ultrazohm/uz_per_torque_box/Project Outputs for uz_per_torque_box/Rev01/confirmed_production_files/6934703554560-Produce_DanZhi.SMT_Snapshot.Top.3469584A_Y79.SMT02406261808483.png

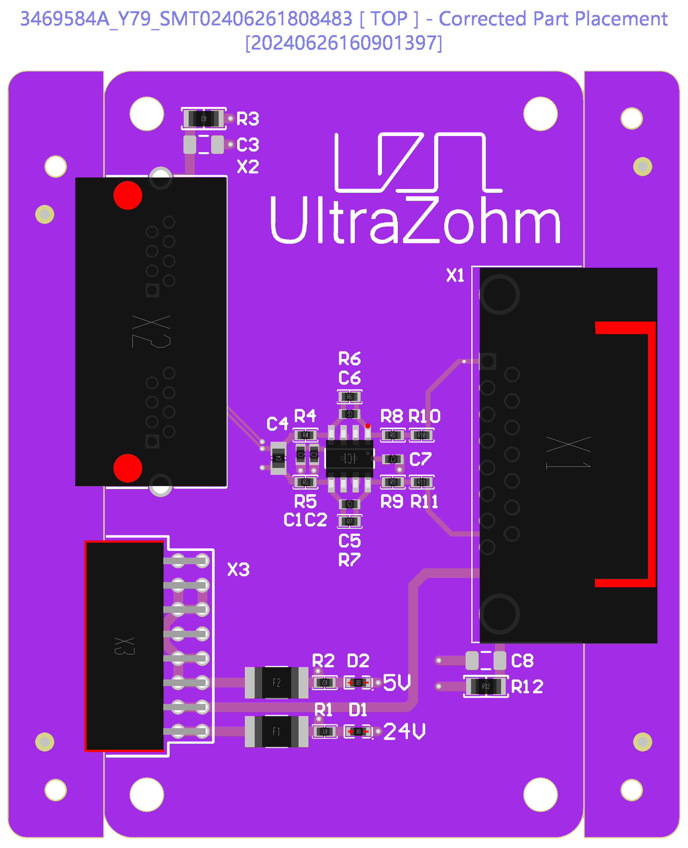
Project Outputs for uz_per_torque_box/Rev01/confirmed_production_files/6934703554560-Produce_DanZhi.SMT_Snapshot.Top.3469584A_Y79.SMT02406261808483.png
