ultrazohm/uz_per_torque_box/Project Outputs for uz_per_torque_box/Rev01/BOM/BOM_JLC-uz_per_torque_box(Default).xlsx

Quantity | Comment | Designator | Manufacturer | Value | Description | Footprint | Voltage | Dielectric | Manufacturer Part Number | LCSC Part Number
1 | 0.1 µF | C1 | KEMET | 0.1 µF | Capacitor 0603, 50 VDC, 0.1 µF, X7R | C_0603 |  |  | C0603X104K5RAC7411 | C14663
1 | 1 nF | C2 | YAGEO | 1 nF | Capacitor 0603, 50 VDC, 1 nF, NP0 | C_0603 |  |  | CC0603JRNPO9BN102 | C106246
1 | 2.2 µF | C4 | KEMET | 2.2 µF | Capacitor 0805, 16 VDC, 2.2 µF, X7R | C_0805 |  |  | C0805X225J4RECAUTO
2 | 22 pF | C5, C6 | KEMET | 22 pF | Capacitor 0603, 50 VDC, 22 pF, X7R | C_0603 |  |  | C0603C220J5RACTU
1 | 1 µF | C7 | Taiyo Yuden | 1 µF | 50V 1uF X7R ±10% 0603 Multilayer Ceramic Capacitors MLCC - SMD/SMT ROHS | C_0603 |  |  | UMK107AB7105KA-T | C105174
2 | 150060BS84000 | D1, D2 | Wuerth Elektronik |  | WL-SMCW SMD Mono-color Chip LED Waterclear Blue | WL-SMCW_0603 |  |  | 150060BS84000 | [NoParam], C5197644
2 | Littelfuse_PTC_1812 | F1, F2 | Littelfuse | PTC, 1.1 A, 24V | POLYSWITCH RESETTABLE DEVICES | 1812_PTC_Polyfuse_Littelfuse | 24V |  | Littelfuse_PTC_1812 | C70119
1 | ADA4940-1ARZ-R7 | IC1 | Analog Devices | differential ADC driver | Differential ADC Driver | SOIC-8-N |  |  | ADA4940-1ARZ-R7
4 | Mounting Hole | MH1, MH2, MH3, MH4 | Mounting Hole | Mounting Hole | Mounting Hole | MH_3.4 |  |  | Mounting Hole
1 | 24k9 | R1 | Vishay | 24k9 | SMD resistor 1% | RES 0603_1608 |  |  | CRCW060324K9FKEA
1 | 3k | R2 | KOA Speer | 3k | SMD resistor E24 series | RES 0603_1608 |  |  | RK73B1JTTD302J
2 | 0R | R3, R12 | UNI-ROYAL | 0R | 250mW Thick Film Resistors ±800ppm/℃ ±1% 0Ω 1206 Chip Resistor - Surface Mount ROHS | RES 1206_3216 |  |  | 1206W4F0000T5E | C17888
2 | 51R1 | R4, R5 | YAGEO | 51R1 | SMD resistor 0.1% | RES 0603_1608 |  |  | RT0603BRD0751R1L | C2684558
6 | 1k | R6, R7, R8, R9, R10, R11 | IRC / TT Electronics | 1k | SMD resistor 0.1% | RES 0603_1608 |  |  | PCF-W0603LF-03-1001-B-P-LT | C110776
1 | DS1037-15FNAKT74-0CC | X1 | CONNFLY Elec |  | 15 Female D-Sub Shrouded 2 3A -40℃~+85℃ Plugin D-Sub/DVI/HDMI Connectors ROHS | PCB - MISC - DSUB15 |  |  | DS1037-15FNAKT74-0CC | C77835
1 | RJHSE538002 | X2 | Amphenol |  | CAT5, RJ45 Connector, 1x2 | RJHSE-5380-02 |  |  | RJHSE538002
1 | IPL1-108-01-L-D-RA-K | X3 | SAMTEC |  | 2.54 mm Double Row Termin Assembly (right angle) | IPL1-108-01-L-D-RA-K |  |  | IPL1-108-01-L-D-RA-K
