ultrazohm/uz_per_torque_box/cad/Assembly.SLDASM

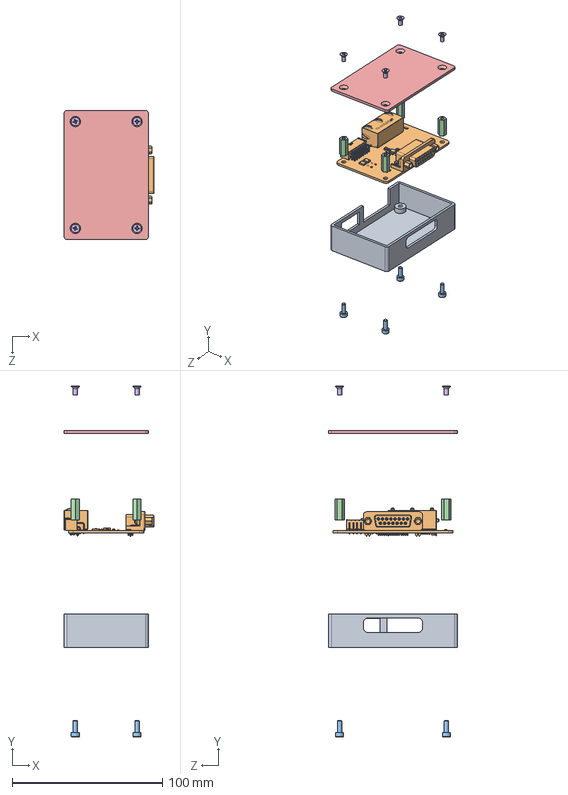
[picture p2: CAD file, 2024-06-26]
cad/Assembly.SLDASM
59.7 x 233.3 x 86.0 mm
housing_body
uz_per_torque_box
socket head cap screw 4762_din x 4
Wuerth_970140321_Steel_Spacer_Stud_M3x14 x 4
housing_cover
countersunk flat head cross recess screw_din x 4
