ultrazohm/uz_per_torque_box/cad/housing_body.SLDPRT

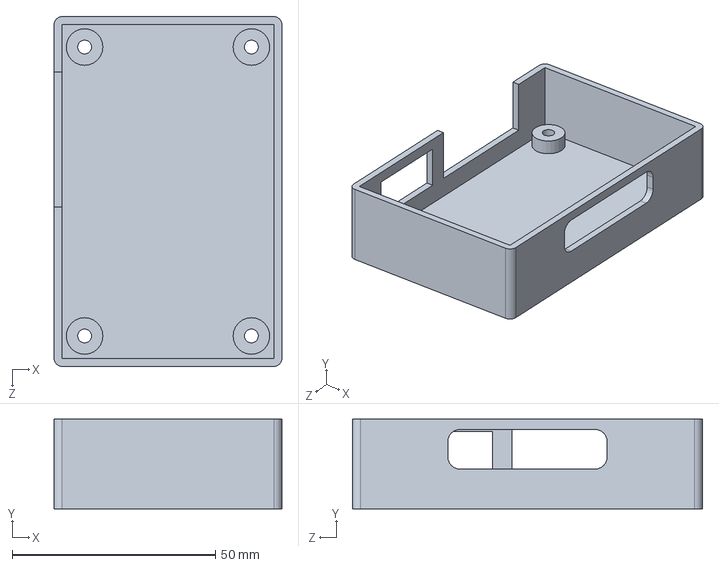
[picture p3: CAD file, 2024-06-26]
cad/housing_body.SLDPRT
56.0 x 22.0 x 86.0 mm
