ultrazohm/uz_per_torque_box/cad/Wuerth_970140321_Steel_Spacer_Stud_M3x14.SLDPRT

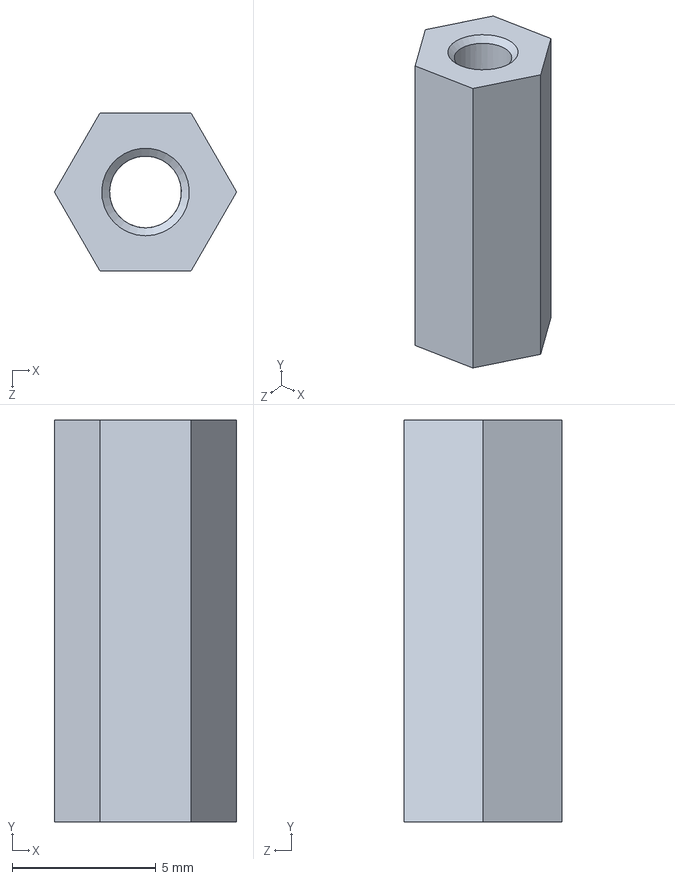
[picture p4: CAD file, 2024-06-19]
cad/Wuerth_970140321_Steel_Spacer_Stud_M3x14.SLDPRT
6.35 x 14.0 x 5.50 mm
