ultrazohm/uz_per_torque_box/cad/housing_cover.SLDPRT

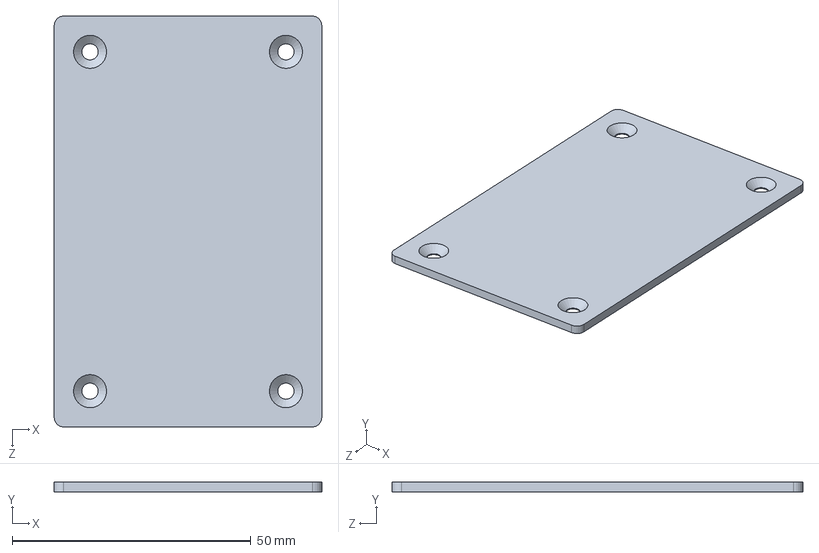
[picture p5: CAD file, 2024-06-19]
cad/housing_cover.SLDPRT
56.0 x 2.00 x 86.0 mm
