ultrazohm/uz_per_torque_box/LTSpice/signal_path.asc

C1: cap; 1µ
C2: cap; 22p
C3: cap; 22p
C4: cap; 2.2µ
R1: res; 1k
R2: res; 1k
R3: res; 51.1
R4: res; 1k
R5: res; 1k
R7: res; 1k
R8: res; 1k
R9: res; 51.1
U1: ADA4940
V1: voltage; 5
V2: voltage; SINE(0 10 100)
Named nets: 0, 5v, o+, o-, RJ_N, RJ_P, Torque_N, Torque_P
.tran 20m
;ac dec 100 1 100k
