ultrazohm/uz_per_torque_box/(list of files, drawings)

Other design files:
TopSheet.SchDoc
Torque_Signal_Conditioning.SchDoc
uz_per_torque_box.PcbDoc
uz_per_torque_box.PrjPCB
