ultrazohm/uz_per_torque_box/(commit log)

2024-06-07 initial draft of schematic and pcb
    [TopSheet.SchDoc, Torque_Signal_Conditioning.SchDoc, uz_per_torque_box.PcbDoc, uz_per_torque_box.PrjPCB]
2024-06-08 added LTSpice sim, working draft of circuitry, still to be checked against datasheet limitations of ADA4940
    [Torque_Signal_Conditioning.SchDoc, uz_per_torque_box.PcbDoc, uz_per_torque_box.PrjPCB]
2024-06-11 fixes in schematic acc. to feedback from dennis
    [Torque_Signal_Conditioning.SchDoc, uz_per_torque_box.PcbDoc]
2024-06-13 final draft of the pcb for review
    [TopSheet.SchDoc, Torque_Signal_Conditioning.SchDoc, uz_per_torque_box.PcbDoc, uz_per_torque_box.PrjPCB]
2024-06-17 changed grounding of connectors acc. to feedback. replaced info box and serial no field to the bottom
    [Torque_Signal_Conditioning.SchDoc, uz_per_torque_box.PrjPCB]
2024-06-17 changed layer stack to 2-layer, exported step file of board
2024-06-17 fixed position of DSub15, since that footprint and 3d body dont fit to each other. For using conventional DSub connectors the 3d body of the lib part hast to hang over the board outline approx. 2 mm
2024-06-19 replaced DSub15 to one available at JLC, DRC i.O., created OutputJobFiles for production
    [BOM_JLC-uz_per_torque_box(Default).xlsx, BOM_JLC-uz_per_torque_box(Default)_JLC_Upload.xlsx, Pick Place for uz_per_torque_box(Default).csv, Torque_Signal_Conditioning.SchDoc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]
2024-06-19 moved connectors further over the board outline to fit them better into the housing of the pcb. regenerated outputjob files, added housing CAD data
    [Assembly.SLDASM, BOM_JLC-uz_per_torque_box(Default).xlsx, Pick Place for uz_per_torque_box(Default).csv, Wuerth_970140321_Steel_Spacer_Stud_M3x14.SLDPRT, housing_body.SLDPRT, housing_cover.SLDPRT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]
2024-06-20 updated pcb project with new 3d body for dsub15. recreated step file and updated cad project. updated outputjobfiles
    [Assembly.SLDASM, BOM_JLC-uz_per_torque_box(Default).xlsx, Pick Place for uz_per_torque_box(Default).csv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]
2024-06-26 moved Samtec IPL 1mm inwards, for hopefully better mountability in the housing. exported step, regenerated outputjob
    [BOM_JLC-uz_per_torque_box(Default).xlsx, BOM_JLC-uz_per_torque_box(Default)_JLC_Upload.xlsx, Pick Place for uz_per_torque_box(Default).csv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]
2024-06-26 updated CAD assembly with updated step file of pcb, added a rib to housing above IPL connector
    [Assembly.SLDASM, housing_body.SLDPRT]
